77qhtjd-bit/haptic-lane-guide/cad/EccentricWeight_130motor.stl

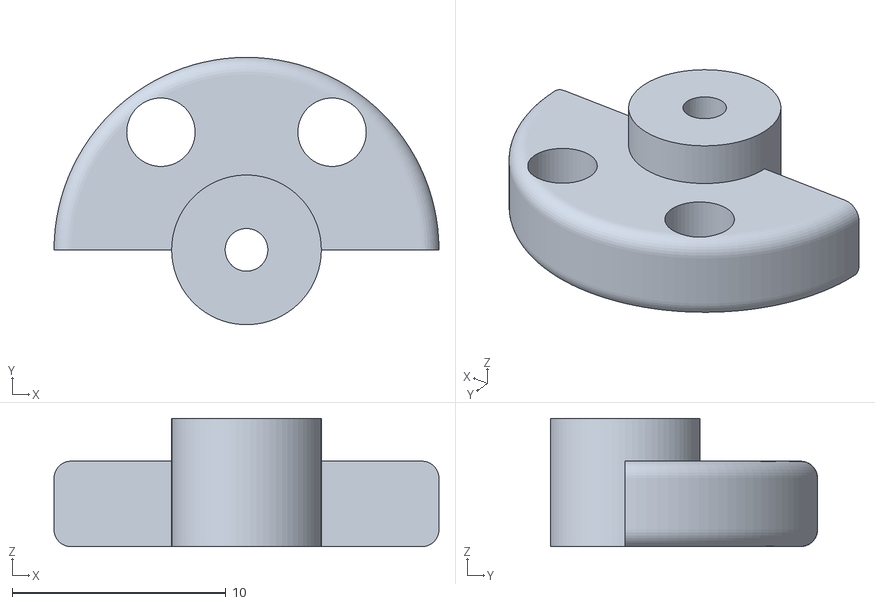
[picture p5: CAD file, 2026-10-25]
cad/EccentricWeight_130motor.stl
18.0 x 12.5 x 6.00
