77qhtjd-bit/haptic-lane-guide/cad/case 2.stl

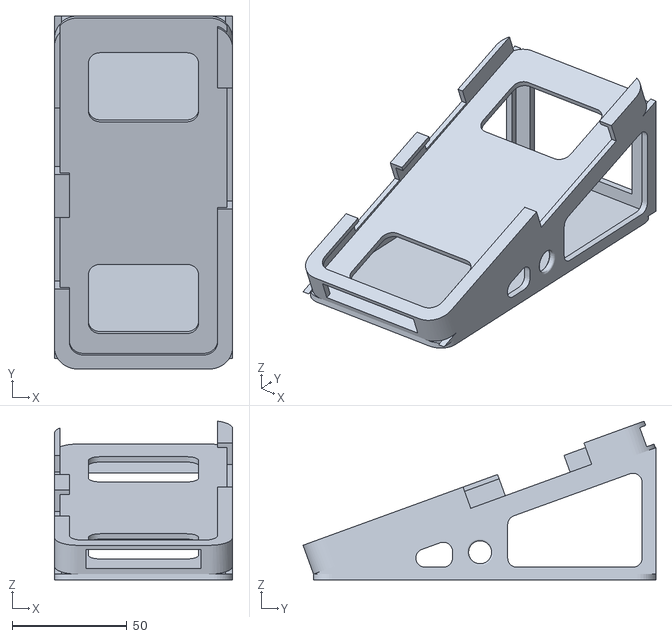
[picture p6: CAD file, 2026-10-25]
cad/case 2.stl
77.5 x 153.6 x 69.1
