77qhtjd-bit/haptic-lane-guide/cad/cad 1.step

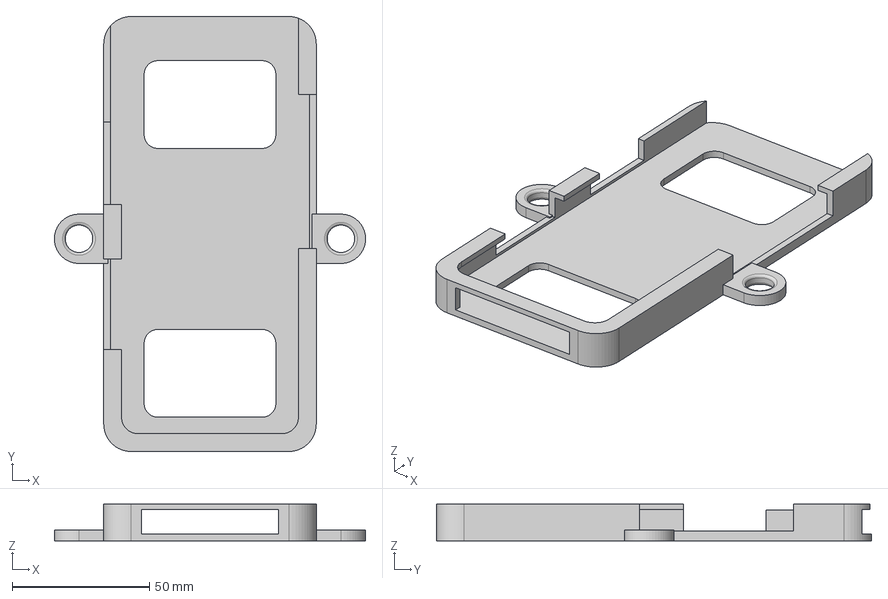
[picture p7: CAD file, 2026-10-25]
cad/cad 1.step
113.5 x 158.6 x 13.3 mm
