77qhtjd-bit/haptic-lane-guide/(list of files, cad)

Other CAD files:
cad/Calhacks_Bosung_kim.stl
cad/iphone holder 16 pro.f3d
