77qhtjd-bit/haptic-lane-guide/(commit log)

2026-10-24 chore: start project with HACK.md plan and repo hygiene
    Scoped MVP, cut list, stack decision gate (Plan A phone-only via
    Bluefy Web Bluetooth, Plan B laptop OpenCV server), .gitignore and
    .env.example with no secrets.
2026-10-24 feat: add IMU ground projection and lane-line peak detection spike
    ground.js projects mask pixels onto the track using the phone's
    attitude, finds track lines as lateral histogram peaks, and
    re-estimates camera height from the 1.22m lane width. detector.js
    wraps the OpenCV.js white-line mask. spike-ground.html runs it on the
    phone and shows per-line jitter. Node tests cover the geometry.
2026-10-24 feat: add yaw heading search so lane peaks survive body rotation
    Body yaw tilts track lines in the ground frame and smears the lateral
    histogram (10 deg drops the peak to ~35%). findHeading rotates the
    points to the angle with the sharpest histogram, searching around the
    previous frame's heading; the result doubles as the e_psi measurement.
    Tests cover yaw -18..18 deg; beyond ~18 deg the portrait 1x view keeps
    only one own-lane line.
2026-10-24 feat: add Kalman + PD haptic control, belt firmware, offline OpenCV
    - web/lane/tracker.js: lock the runner's lane and follow the same two
    lines by gated association; one-line fallback, coast then LOST, and
    outside-left/right instead of re-locking a neighbor lane.
    - web/control: Kalman filter over [eY, vY, ePsi] with gyro yaw-rate
    prediction and an outlier gate; PD + heading controller mapped to
    motors 1-5 with hysteresis; 8-byte BLE command packet + Web Bluetooth.
    - firmware/belt_r4: UNO R4 WiFi BLE peripheral with local pulse timing,
    300 ms watchdog and Serial Plotter telemetry.
    - Vendor OpenCV.js (the docs.opencv.org 4.10.0 URL returns 404) and add
    a network-first service worke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
2026-10-24 feat: adopt team BLE pipeline, add run logging, audio cue and lane simulation
    - Use the team's measured Plan A transport: firmware/lane_actuator_ble
    (LaneActuator, [seq, L1..L5], ACK, 300 ms watchdog) replaces belt_r4;
    protocol.js maps controller output to per-motor pulse levels and ports
    the auto-reconnect / stall / getDevices logic from runner-test.html.
    - Run logger: per-frame CSV (raw + Kalman eY/ePsi, u, zone, L1..L5,
    imu_age_ms) and RMS summary per condition (belt / audio / none).
    - Audio comparison cue (stereo beeps with the belt's rhythm).
    - Simulate lane: phone tilt = lateral drift, to test the belt without a lane.
    - Handle iOS IMU stalls: predict from the frame loop, down-w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
    [lane_actuator_ble.ino]
2026-10-24 fix: ignore wide white areas when finding lane lines; drop lane simulation
    - detector: top-hat filter keeps only white runs up to 7 px wide, so
    walls, white floors and lights no longer flood the line mask.
    - findPeaks: reject histogram humps wider than 25 cm and take the
    relative threshold from narrow peaks only, so a bright area cannot
    hide the real lines. Test covers a white floor patch next to the lane.
    - Remove the tilt-to-drift "Simulate lane" mode (team decision).
2026-10-24 feat: fit curved lanes from per-segment peaks; keep far lines visible
    - segmentPeaks: line peaks in 1-2 / 2-3 / 3-4 / 4-5.5 m segments.
    - LaneTracker fits both lines as parallel quadratics y = a + b x + c x^2
    (falls back to a line or an offset with fewer segments): eY at the
    runner, ePsi against the tangent, and curvature.
    - Controller: curvature feedforward (lean into the bend).
    - Page: draws the fitted curved lane/centerline; CSV logs curvature.
    - Detector: 240x320 processing and a 2x2 speckle open. At 120 px a 5 cm
    line beyond 2 m was 1-2 px and the 3x3 open erased it, so only 1-2 m
    was used. Synthetic R = 36.5 m bend now fits R 38-39 m, eY < 1 cm.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
2026-10-24 feat: runner-anchored sliding-window lanes, filled lane display, lane width input
    From the first phone tests: false lines on a chair leg and bare floor,
    lock refused on a 73 cm practice lane, and near tape erased by the line
    filter.
    - Tracker: start at the line just left and right of the runner in the
    nearest segment and follow each line segment by segment (sliding
    window); a line must continue over 2+ segments; candidates are scored
    by length and straightness so a chain that hops from junk onto a line
    loses. candidate() previews the lane before Lock; no lane -> nothing.
    - Lane width is configurable (practice lanes differ from 1.22 m).
    - Detector: the thin-line filter limit is 15 cm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
2026-10-24 feat: accept a lane width range (0.5-1.0 m on the page) instead of one value
    Taped practice lanes vary and vision measures width only roughly, so
    lock accepts any line spacing in [minWidth, maxWidth] and the tracker
    then follows the measured width. Library default stays track-sized
    (0.9-1.55 m); the page defaults to 0.5-1.0 m.
2026-10-24 feat: draw the PD reference centerline and the runner's path; log width, matched lines and cue
    The fill/edge redraw had dropped the centerline. Draw the fitted
    centerline the controller measures eY and ePsi against (white dashed)
    and the runner's straight-ahead path (cyan), so the gap the belt is
    correcting is visible. CSV gains lane_width_m, matched (L/R) and cue.
2026-10-24 fix(tracker): keep the lane through jogging heading jitter
    Measured on a 182 s jogging clip from the real track (runner outside the
    lane only at 1:34-1:37, 1:43-1:50, 2:38-2:40, 2:54-2:58), replayed frame by
    frame through web/replay.html with h=1.5 m, lag 60 ms:
    - Slope prediction: the previous slope was re-rotated by the frame-to-frame
    heading change, but the detector already re-aligns its frame to the lane,
    so the rotation was counted twice. With ±8 deg/frame heading jitter the
    predicted slope reached ~20 deg, predicted lines missed the real ones by
    ~40 cm at 1.5 m and the lane coasted to LOST. Now the slope is carried
    over and decays (slopeDecay) only while coasting.
    - Coastin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
2026-10-24 chore(spike-ground): default camera height 1.5 m
    Measured on three real-track clips (chest mount, beta ~65 deg): at h 1.3 m the
    locked lane measured 102-108 cm instead of 122 cm; the line spacing implies
    h 1.48-1.54 m, and at 1.5 m the measured width is 118-124 cm. Measure the
    mount height and adjust if it differs.
2026-10-24 fix(controller): stop the belt flipping left/right with every jogging stride
    Measured by replaying the real-track jogging clip (runner inside the lane except at
    1:34-1:37, 1:43-1:50, 2:38-2:40, 2:54-2:58) through the live pipeline:
    the chest camera yaws ±14-18 deg at stride frequency (1.36 Hz vs 1.40 Hz stride)
    and the measured heading carries a steady +3..6 deg offset on all three clips
    (mount yaw). Through the 2.5 m pure-pursuit lookahead plus the vY damping term,
    the effort swung ±50-90 cm, so while the runner was inside the lane the belt
    changed cue ~390 times/min, reversed left<->right 43 times/min and gave the big
    turn cue 61% of the time.
    Now (with a frame time passed to step()):
    -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
2026-10-24 feat(tracker): hybrid rules - straddle re-lock, settle period, width check, jump guard
    Each rule is a config switch; all off (lockStraddle=false, settleFrames=0,
    widthCheck=0, jumpGuard=0) reproduces the previous tracker exactly (jogging
    replay: 5224/5224 frames identical except processing time).
    - lockStraddle: lock / re-lock takes the nearest continuing line on each side
    of the runner (left < 0 < right) about one lane width apart; a chain that
    hops from a short white thing onto a line yields to the next straight one.
    - settleFrames (15 = 0.5 s): after a lock the output is lowConfidence, the
    inside/outside status is not switched, and the controller caps the cue at
    the small-turn zo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
2026-10-24 feat(tracker): check matched peaks against the white points' direction (hybrid line check)
    The detector now also returns its lane-aligned ground points; tracker.update()
    takes them as an optional 4th argument. Around each matched peak the white
    points within 10 cm of the line over ±0.4 m must run along the lane; a fitted
    direction more than tan 15° off the lane course is a crossing line (staggered
    start lines, painted marks, shadow edges) and that peak is dropped from the
    chain (verifySlope; 0 = off).
    Jogging replay with ground truth, inside-the-lane time:
    correct inside 88.1 -> 95.5%, false outside 9.6 -> 2.3%, line matched
    86.4 -> 88.7%; real departures detected 84.3 -> 83.5%; processin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
2026-10-24 feat(tracker): fill a side the peaks missed by tracing the ground points (hybrid fill)
    When neither peak chain was found for a side, that line is traced through the
    lane-aligned ground points from its predicted position: 0.25 m steps, ±7 cm
    window, direction change capped per step, 3 empty steps end it; used if it
    covers 1.5 m, resampled at the segment distances (traceMinLength; 0 = off).
    Jogging replay, inside-the-lane time: correct inside 95.5 -> 96.2%,
    lost 2.1 -> 1.4%, line matched 88.7 -> 90.0%, false outside 2.3 -> 2.4%,
    real departures detected 83.5 -> 84.3%, re-locks 4 -> 3. Walking unchanged
    (outside 10.3 -> 10.6%), running stop cue 3.3 -> 2.5%. Processing unchanged
    (2.6-2.8 ms me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
2026-10-25 feat(spike-ground): switch tracker/controller rules and inputs from the address (t_<key>, c_<key>, h, lag, ...)
    Same parameters as web/replay.html, e.g. ?t_verifySlope=0&c_deadband=0.15&h=1.4.
    The active overrides are shown above the log.
2026-10-25 feat(controller): curve guidance - keep the runner turning on track bends
    On a bend, "centered" must not mean silence/heartbeat: a blind runner keeps
    going straight and is pushed outward before any correction comes. With frame
    times, the controller now tracks a curve state from the averaged lane
    curvature (on |k| >= 0.0125/m (R 80 m), off <= 0.0067/m, 1 s average, 0.5 s
    hold) and, while centered on a bend, gives Pattern.CURVE: a double tap
    (150 ms pulses for 0.4 s) at the start, then gentle 800 ms pulses on the
    small-turn motor toward the bend (M2 for left). Corrections (STEER) and the
    outside/lost cues work as before on top. Only left bends by default
    (counterclockwise track; curveSides 0 =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
2026-10-25 feat: on-page tuning panel for tracker/controller rules (spike-ground)
    web/control/tuning.js builds a collapsible panel (belt cue, curve guidance,
    lane tracking rules); changes apply immediately to the running tracker and
    controller, are kept on the phone (localStorage) and can be copied as a link
    (?t_<key>/c_<key>). Precedence: defaults < saved < address. Non-default
    values are highlighted and summarized above the log.
2026-10-25 feat(controller): cue dwell - no single stray pulses from 0.1-0.3 s cue blips
    A new cue is sent only after it persisted cueConfirmS (0.35 s); big turn,
    outside and stop come after cueEscalateS (0.15 s); a sent cue is kept at least
    cueHoldS (0.8 s, one pulse at least) before a calmer one replaces it. The
    curve double tap now starts when the curve cue is actually sent. Only with
    frame times; each 0 = off (all off = previous behavior, tested). Added to the
    tuning panel.
    Replay (cue episodes, dwell off -> on):
    jogging 32.0 -> 14.2 changes/min, episodes < 0.3 s 31 -> 0, 0.3-0.8 s 21 -> 2;
    walking 20.2 -> 15.4/min, < 0.3 s 10 -> 2; running 33.4 -> 17.9/min,
    < 0.3 s 11 -> 1. Real departures (joggi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
2026-10-25 feat(firmware): selectable motor pin set (D2..D6 or A1..A5), on/off drive with digitalWrite
    The hardware may wire the motor signals to D2..D6 or to A1..A5 (left to
    right). One #define picks the set; the startup message prints it. Motors
    are switched fully on/off with digitalWrite (strength = pulse rate), so pins
    without PWM work; MOTOR_ACTIVE_HIGH covers drivers that switch on with LOW;
    PULSE_ON_MS documented for motors that need longer to spin up.
    Host simulation (stubbed ArduinoBLE/LED matrix), both pin sets: pins set to
    OUTPUT and off at start; 2 s of commands [255,128,1,0,254] give continuous
    M1, 4/2/0/17 pulses of 60 ms on M2..M5; all off 301 ms after the last
    command. HANDOFF.md updat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
2026-10-25 tune(belt): 200 ms motor pulses, fast patterns 300-350 ms
    Coin motors on the belt: 60/100/150 ms pulses felt weak, 200 ms clearly (Oct 25 test on M3/M5).
    Firmware PULSE_ON_MS 60 -> 200, capped at 2/3 of the period. Controller fast patterns lengthened so
    each pulse can be 200 ms: big turn 150 -> 350 ms, stop 120 -> 300 ms, curve double tap 150 -> 350 ms.
    Belt previews in replay/spike-ground follow the new pulse length.
2026-10-25 feat(spike-ground): runner UI - belt on after Lock, lock taps, screen kept on, replay-style belt preview
    - Removed the experiment panel (belt/audio/no-feedback runs, results table, CSV) and the audio cue
    from the page; logger.js/audio.js stay in the repo.
    - The belt now vibrates whenever a lane is locked; a Belt ON / PAUSED toggle sends all-zero
    commands while paused (the board keeps a live link).
    - Lock confirmation: two 200 ms taps on M3, since the runner cannot see the screen.
    - Screen Wake Lock on Start (iOS stops the camera when the screen turns off); without it the page
    asks to set Auto-Lock to Never.
    - Belt preview copied from replay.html (firmware pulse timing, cue colors, peri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
2026-10-25 feat(spike-ground): tap a motor in the belt preview to test it (on for 1 s)
    Works before Start (sends from a timer) and while running (overrides the cue for 1 s, also when the
    belt is paused). Logs a hint when the belt is not connected.
2026-10-25 feat(spike-ground): record the run (camera video + IMU) for the replay demo
    Record clip / Save clip buttons: the live camera stream and full-rate IMU are saved in the same
    format as web/record.html (rec_<time>.mp4 + .json, same clock), so web/replay.html plays the run
    back through the pipeline and can drive the real belt. Lock and belt pause/resume are logged as
    events. New module web/control/clip.js; offline cache v3 adds tuning.js and clip.js.
2026-10-25 fix(spike-ground): lock confirmation taps on M2+M4 (our belt has no M3)
2026-10-25 docs(README): running and app GIFs, new UI and replay demo steps, 4-motor belt (no M3)
    GIFs from the jogging clip (20-26 s): the raw chest-camera view and the app on the same footage.
2026-10-25 docs(README): hardware photo, 18 s GIFs, jogging sample clip with a one-click replay link
    samples/jogging: the original jogging clip (video + IMU) behind the measured results; a re-encoded
    28 MB copy changed the score (96.2 -> 89.5% inside correct), so the original is kept. Hardware
    photo resized to 900x1200 with metadata removed.
2026-10-25 feat(cad): add 3D-printed chest phone mount and motor eccentric weight models
    [Calhacks_Bosung_kim.stl, EccentricWeight_130motor.stl, cad 1.step, case 2.stl, iphone holder 16 pro.f3d]
2026-10-25 docs(README): photo of the device worn, next to the hardware photo
